Prasana-sys/RF_Controler_UHP/README.md

# RF_Controler_UHP

Controller Firmware - Contains STM32 code files

STM_RF_PCB - Contains PCB files

Documents - Documents used to build this project

old_RFST - old PCB design
