Prasana-sys/RF_Controler_UHP/STM_RF_PCB/3D models/sma-angled-1.snapshot.1/SMA ANGLED.JPG

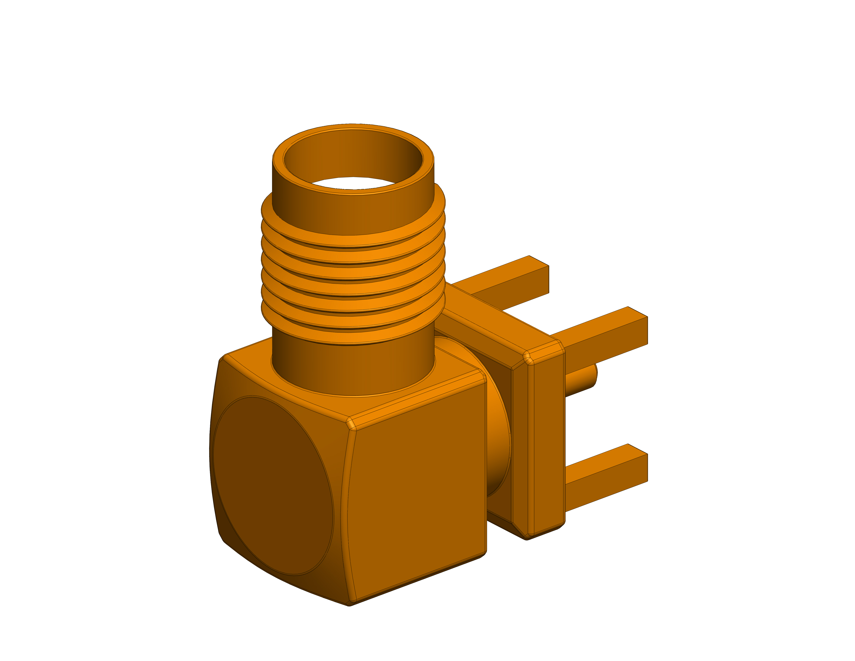
STM_RF_PCB/3D models/sma-angled-1.snapshot.1/SMA ANGLED.JPG
