Prasana-sys/RF_Controler_UHP/Links to buy components.txt

RF Transceiver - https://www.mouser.com/ProductDetail/Nordic-Semiconductor/NRF24L01P?qs=yqaQSyyJnNiKlgjT8AqoOw%3D%3D
