Prasana-sys/RF_Controler_UHP/STM_RF_PCB/3D models/12mm-x-12mm-tactile-switch-push-button-1.snapshot.1/12mm x 12mm Tactile switch.iges

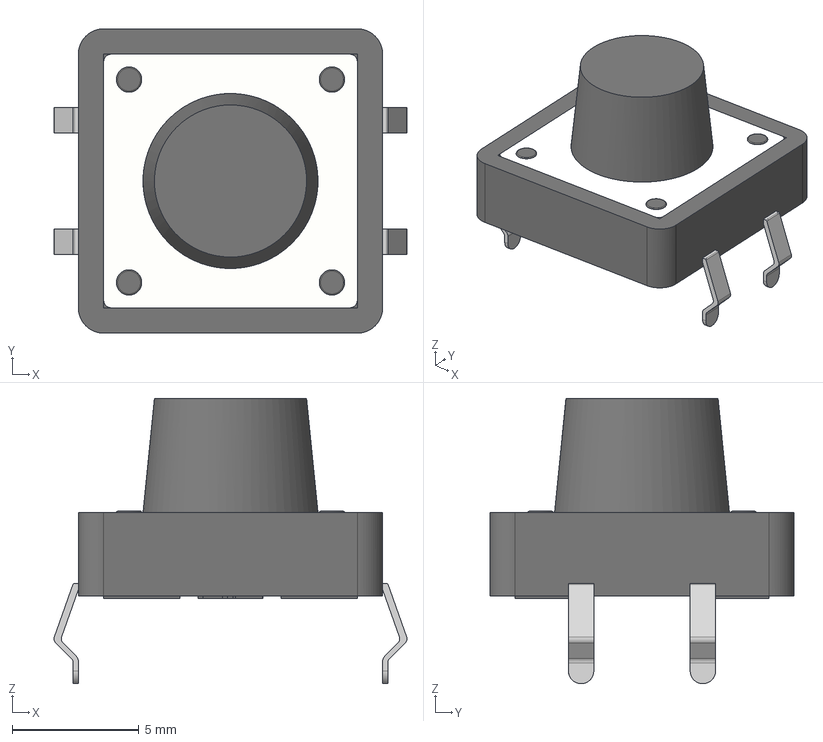
[picture p2: CAD file, 2024-05-29]
STM_RF_PCB/3D models/12mm-x-12mm-tactile-switch-push-button-1.snapshot.1/12mm x 12mm Tactile switch.iges
13.9 x 12.0 x 11.2 mm
