Prasana-sys/RF_Controler_UHP/STM_RF_PCB/3D models/micro-usb-female-type-b-connector-smd-1.snapshot.3/AB2_USB_MICRO_SMD.stl

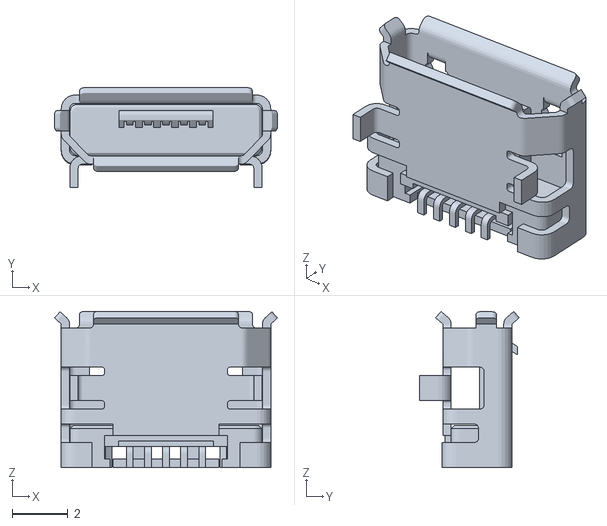
[picture p3: CAD file, 2024-05-21]
STM_RF_PCB/3D models/micro-usb-female-type-b-connector-smd-1.snapshot.3/AB2_USB_MICRO_SMD.stl
8.00 x 3.57 x 5.60
