Prasana-sys/RF_Controler_UHP/STM_RF_PCB/3D models/sma-angled-1.snapshot.1/SMA ANGLED.STEP

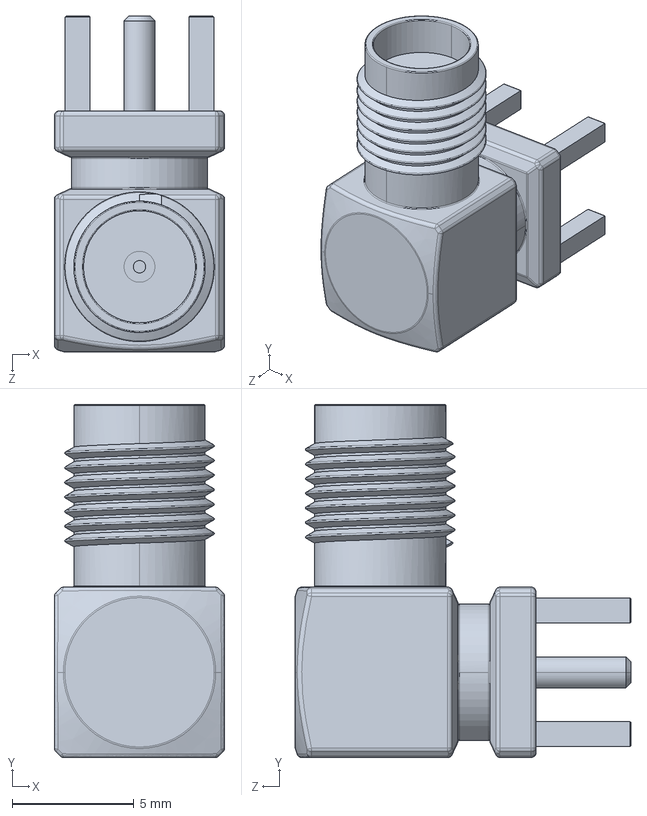
[picture p4: CAD file, 2024-05-24]
STM_RF_PCB/3D models/sma-angled-1.snapshot.1/SMA ANGLED.STEP
7.00 x 14.5 x 13.8 mm
