Prasana-sys/RF_Controler_UHP/STM_RF_PCB/3D models/ul_STM32L432KBU6/UFQFPN-32.step

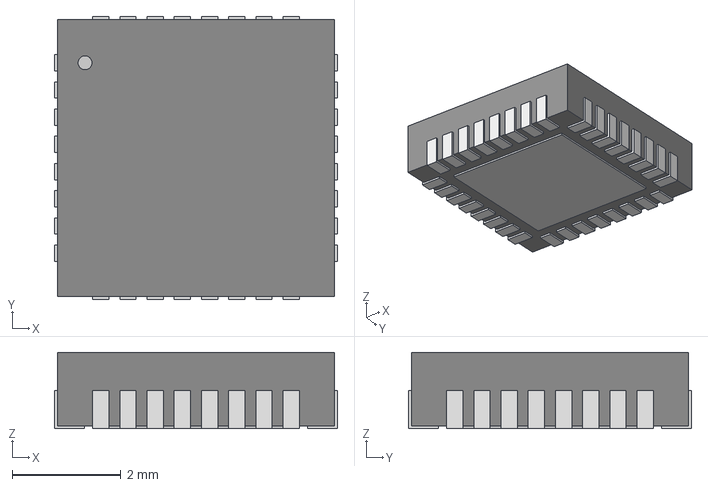
[picture p6: CAD file, 2024-06-02]
STM_RF_PCB/3D models/ul_STM32L432KBU6/UFQFPN-32.step
5.20 x 5.20 x 1.40 mm
