Prasana-sys/RF_Controler_UHP/STM_RF_PCB/3D models/sot23-package-1.snapshot.6/SOT23-6.stp

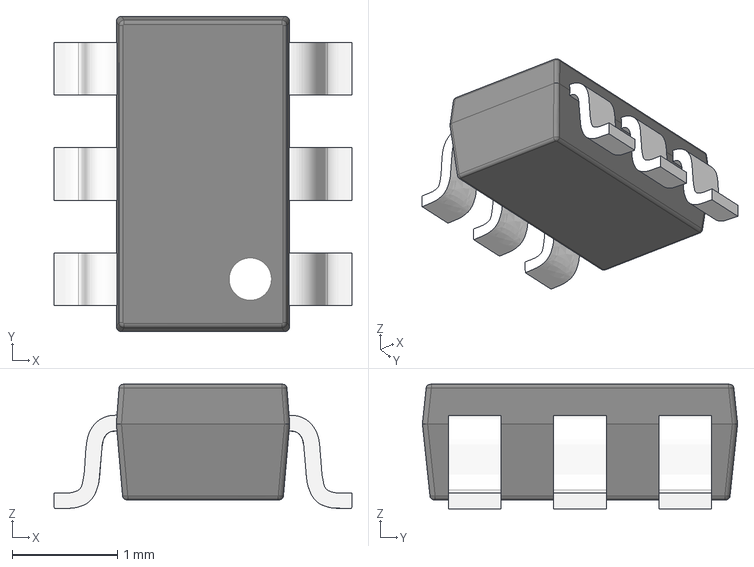
[picture p7: CAD file, 2024-06-02]
STM_RF_PCB/3D models/sot23-package-1.snapshot.6/SOT23-6.stp
2.84 x 3.00 x 1.18 mm
