Prasana-sys/RF_Controler_UHP/(list of files, cad)

Other CAD files:
STM_RF_PCB/3D models/12mm-x-12mm-tactile-switch-push-button-1.snapshot.1/12mm x 12mm Tactile switch Button.step
STM_RF_PCB/3D models/sot23-package-1.snapshot.6/SOT23-4.stp
STM_RF_PCB/3D models/12mm-x-12mm-tactile-switch-push-button-1.snapshot.1/12mm x 12mm Tactile switch.dwg
STM_RF_PCB/3D models/12mm-x-12mm-tactile-switch-push-button-1.snapshot.1/12mm x 12mm Tactile switch.obj
STM_RF_PCB/3D models/sot23-package-1.snapshot.6/SOT23-3.igs
STM_RF_PCB/3D models/sot23-package-1.snapshot.6/SOT23-4.igs
STM_RF_PCB/3D models/sot23-package-1.snapshot.6/SOT23-5.igs
STM_RF_PCB/3D models/sot23-package-1.snapshot.6/SOT23-6.igs
