Prasana-sys/RF_Controler_UHP/STM_RF_PCB/STM_RF_PCB.kicad_pcb

## KiCad design STM_RF_PCB/STM_RF_PCB.kicad_pcb (2024-06-09)

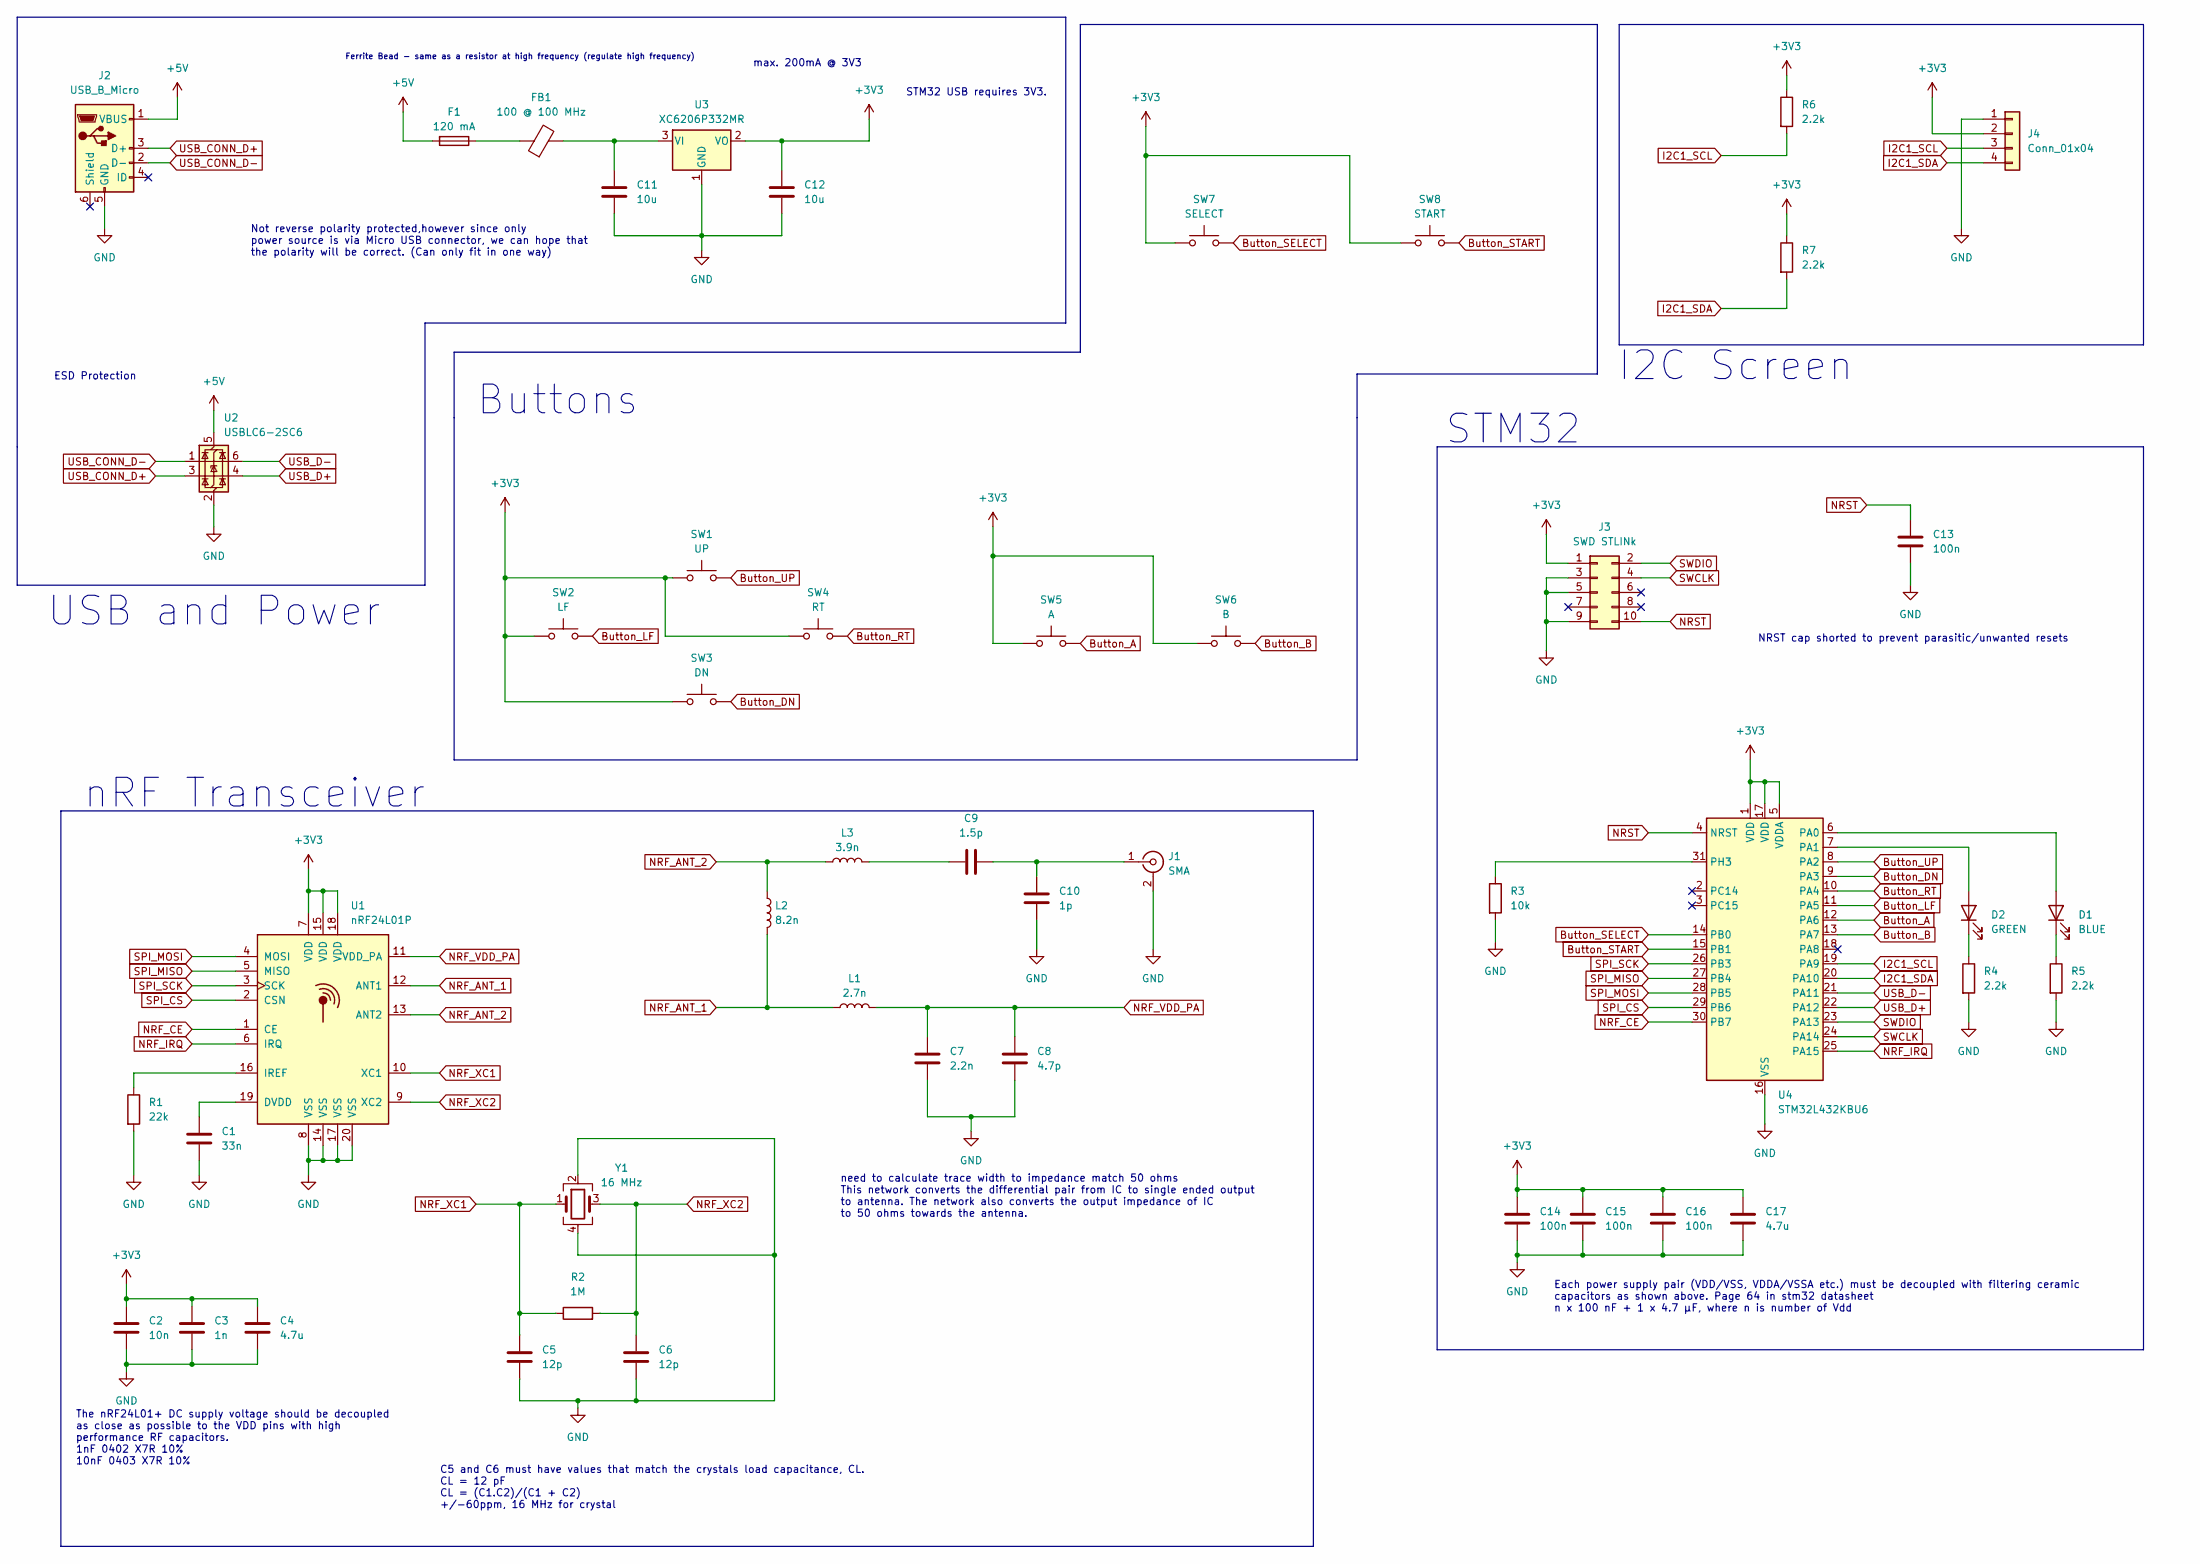
[picture p9: schematic STM_RF_PCB.kicad_sch]

Parts:
C1: 33n; C_0402_1005Metric; Part ID 0402F333M500NT
C2: 10n; R_0603_1608Metric; Part ID 0603B103K101NT
C3: 1n; C_0402_1005Metric; Part ID CC0402KRX7R7BB102
C4, C17: 4.7u; C_0603_1608Metric; Part ID CL10A475KP8NNNC
C5, C6: 12p; C_0402_1005Metric; Part ID 0402CG120J500NT
C7: 2.2n; C_0402_1005Metric; Part ID 0402B222K500NT
C8: 4.7p; C_0402_1005Metric; Part ID 0402CG4R7C500NT
C9: 1.5p; C_0402_1005Metric; Part ID 0402CG1R5C500NT
C10: 1p; C_0402_1005Metric; Part ID 0402CG1R0C500NT
C11, C12: 10u; C_0603_1608Metric; Part ID CL10A106KP8NNNC
C13, C14, C15, C16: 100n; C_0402_1005Metric; Part ID CL05B104KO5NNNC
D1: BLUE; LED_0603_1608Metric; Part ID 19-213/Y2C-CQ2R2L/3T(CY)
D2: GREEN; LED_0603_1608Metric; Part ID 19-217/GHC-YN1P2B18X/6T
F1: 120 mA; Fuse_1206_3216Metric; Part ID nSMD012
FB1: 100 @ 100 MHz; L_0805_2012Metric; Part ID GZ2012D101TF
J1: SMA; SMA-KWE902; Part ID SMA-KWE902
J2: USB_B_Micro; MICRO-02-G2P3-A1T2; Part ID MICRO-02-G2P3-A1T2
J3: SWD STLINk; PinHeader_2x05_P2.54mm_Vertical; Part ID HB-PH8-25425PB2GOP
J4: Conn_01x04; PinSocket_1x04_P2.54mm_Vertical; Part ID C2718488
L1: 2.7n; L_0402_1005Metric; Part ID SDCL1005C2N7STDF
L2: 8.2n; L_0402_1005Metric; Part ID SDCL1005C8N2JTDF
L3: 3.9n; L_0402_1005Metric; Part ID SDCL1005C3N9STDF
R1: 22k; R_0402_1005Metric; Part ID 0402WGF2202TCE
R2: 1M; R_0402_1005Metric; Part ID 0402WGF1004TCE
R3: 10k; R_0402_1005Metric; Part ID 0402WGF1002TCE
R4, R5, R6, R7: 2.2k; R_0603_1608Metric; Part ID 0603WAF2201T5E
SW1: UP; TC-1103-C-D; Part ID TC-1103-C-D
SW2: LF; TC-1103-C-D; Part ID TC-1103-C-D
SW3: DN; TC-1103-C-D; Part ID TC-1103-C-D
SW4: RT; TC-1103-C-D; Part ID TC-1103-C-D
SW5: A; TC-1103-C-D; Part ID TC-1103-C-D
SW6: B; TC-1103-C-D; Part ID TC-1103-C-D
SW7: SELECT; TC-1103-C-D; Part ID TC-1103-C-D
SW8: START; TC-1103-C-D; Part ID TC-1103-C-D
U1: nRF24L01P; QFN-20-1EP_4x4mm_P0.5mm_EP2.5x2.5mm
U2: USBLC6-2SC6; SOT-23-6
U3: XC6206P332MR
U4: STM32L432KBU6; Part ID C94784
Y1: 16 MHz; Crystal_SMD_3225-4Pin_3.2x2.5mm; Part ID X322516MLB4SI

Connections:
+3V3: C2.1, C3.1, C4.1, C12.1, C14.1, C15.1, C16.1, C17.1, J3.1, J4.2, R6.1, R7.1, SW1.1, SW2.1, SW3.1, SW4.1, SW5.1, SW6.1, SW7.1, SW8.1, U1.7 (VDD), U1.15 (VDD), U1.18 (VDD), U3.2 (VO), U4.1 (VDD), U4.5 (VDDA), U4.17 (VDD); also elsewhere on the board
+5V: F1.2, J2.1 (VBUS), U2.5 (VBUS)
Button_A: SW5.2, U4.12 (PA6)
Button_B: SW6.2, U4.13 (PA7)
Button_DN: SW3.2, U4.9 (PA3)
Button_LF: SW2.2, U4.11 (PA5)
Button_RT: SW4.2, U4.10 (PA4)
Button_SELECT: SW7.2, U4.14 (PB0)
Button_START: SW8.2, U4.15 (PB1)
Button_UP: SW1.2, U4.8 (PA2)
GND: C1.2, C2.2, C3.2, C4.2, C5.2, C6.2, C7.2, C8.2, C10.2, C11.2, C12.2, C13.2, C14.2, C15.2, C16.2, C17.2, J1.2 (Ext), J2.5 (GND), J3.3, J3.5, J3.9, J4.1, R1.2, R3.2, R4.2, R5.2, U1.8 (VSS), U1.14 (VSS), U1.17 (VSS), U1.20 (VSS), U2.2 (GND), U3.1 (GND), U4.16 (VSS), U4.32 (VSS), U4.33 (VSS), Y1.2, Y1.4; also elsewhere on the board
I2C1_SCL: J4.3, R6.2, U4.19 (PA9)
I2C1_SDA: J4.4, R7.2, U4.20 (PA10)
NRF_ANT_1: L1.1, L2.2, U1.12 (ANT1)
NRF_ANT_2: L2.1, L3.1, U1.13 (ANT2)
NRF_CE: U1.1 (CE), U4.30 (PB7)
NRF_IRQ: U1.6 (IRQ), U4.25 (PA15)
NRF_VDD_PA: C7.1, C8.1, L1.2, U1.11 (VDD_PA)
NRF_XC1: C5.1, R2.1, U1.10 (XC1), Y1.1
NRF_XC2: C6.1, R2.2, U1.9 (XC2), Y1.3
NRST: C13.1, J3.10, U4.4 (NRST)
unnamed: C9.1, L3.2
unnamed: D1.2 (A), U4.6 (PA0)
unnamed: D1.1 (K), R5.1
unnamed: D2.2 (A), U4.7 (PA1)
unnamed: D2.1 (K), R4.1
unnamed: F1.1, FB1.1
unnamed: C9.2, C10.1, J1.1 (In)
unnamed: C1.1, U1.19 (DVDD)
unnamed: R1.1, U1.16 (IREF)
unnamed: C11.1, FB1.2, U3.3 (VI)
unnamed: R3.1, U4.31 (PH3)
SPI_CS: U1.2 (CSN), U4.29 (PB6)
SPI_MISO: U1.5 (MISO), U4.27 (PB4)
SPI_MOSI: U1.4 (MOSI), U4.28 (PB5)
SPI_SCK: U1.3 (SCK), U4.26 (PB3)
SWCLK: J3.4, U4.24 (PA14)
SWDIO: J3.2, U4.23 (PA13)
USB_CONN_D+: J2.3 (D+), U2.3 (I/O2)
USB_CONN_D-: J2.2 (D-), U2.1 (I/O1)
USB_D+: U2.4 (I/O2), U4.22 (PA12)
USB_D-: U2.6 (I/O1), U4.21 (PA11)

Notes on the sheet:
I2C Screen
Buttons
NRST cap shorted to prevent parasitic/unwanted resets
need to calculate trace width to impedance match 50 ohms This network converts the differential pair from IC to single ended output to antenna. The network also converts the output impedance of IC to 50 ohms towards the antenna.
The nRF24L01+ DC supply voltage should be decoupled as close as possible to the VDD pins with high performance RF capacitors. 1nF 0402 X7R 10% 10nF 0403 X7R 10%
nRF Transceiver
STM32
Each power supply pair (VDD/VSS, VDDA/VSSA etc.) must be decoupled with filtering ceramic capacitors as shown above. Page 64 in stm32 datasheet n x 100 nF + 1 x 4.7 μF, where n is number of Vdd
ESD Protection
Not reverse polarity protected,however since only power source is via Micro USB connector, we can hope that the polarity will be correct. (Can only fit in one way)
C5 and C6 must have values that match the crystals load capacitance, CL. CL = 12 pF CL = (C1.C2)/(C1 + C2) +/-60ppm, 16 MHz for crystal
max. 200mA @ 3V3
STM32 USB requires 3V3.
USB and Power
Ferrite Bead - same as a resistor at high frequency (regulate high frequency)

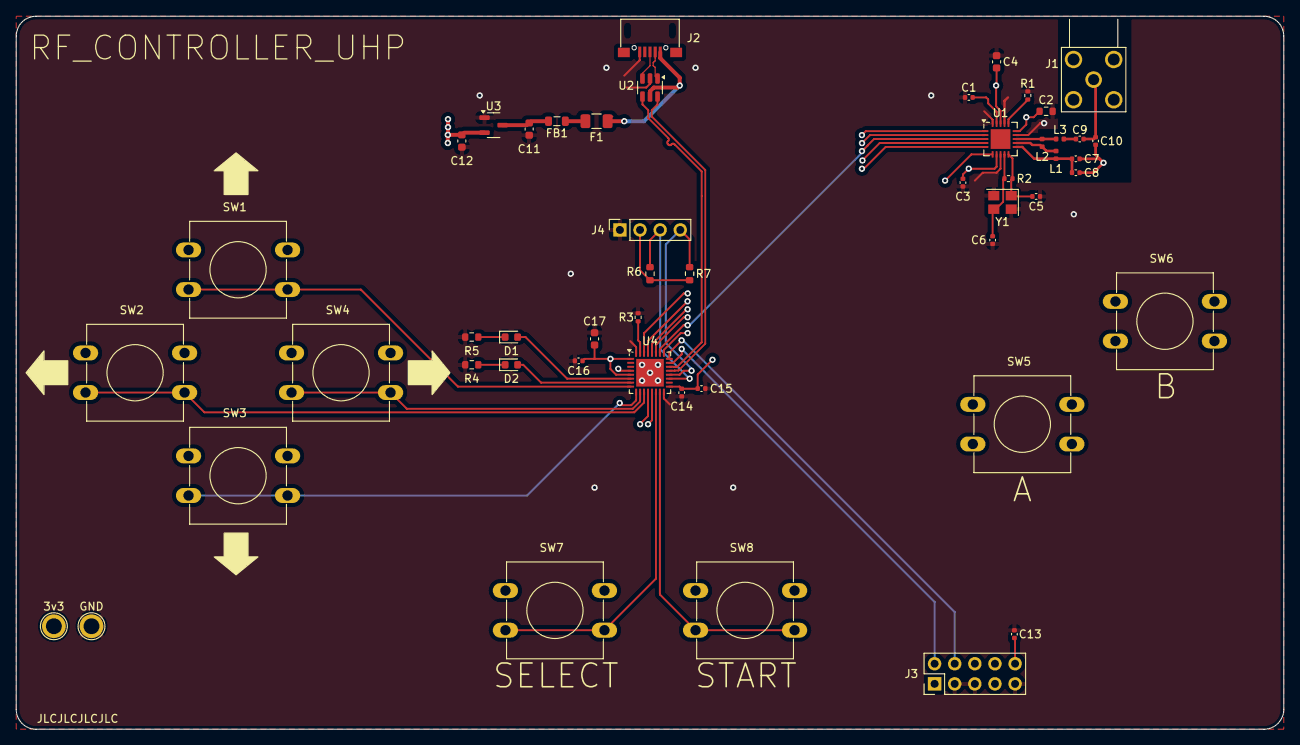
[picture p10: board STM_RF_PCB.kicad_pcb from above]

Board: 4 copper layers, 160.0 x 90.0 mm, 50 parts (0 on the bottom side), 42 nets.

Other parts of the board:
3v3: TestPoint_Plated_Hole_D2.0mm
GND: TestPoint_Plated_Hole_D2.0mm

Their connections:
+3V3: 3v3.1; also elsewhere on the board
GND: GND.1; also elsewhere on the board
