Prasana-sys/RF_Controler_UHP/old_RFST/RFST.kicad_pcb

## KiCad design old_RFST/RFST.kicad_pcb (2024-05-20, an earlier design)

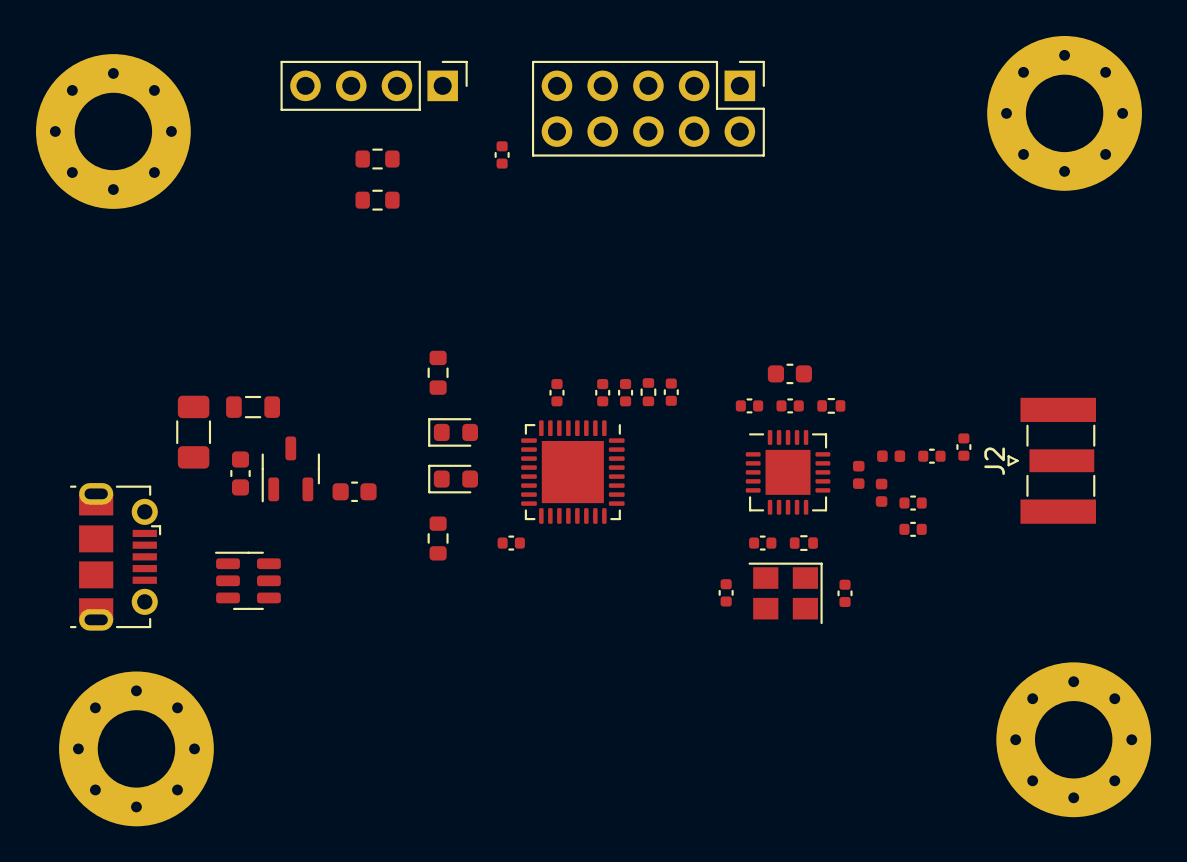
[picture p11: board RFST.kicad_pcb from above]

Board: 2 copper layers, 45 parts (0 on the bottom side), 34 nets, no tracks yet.

Parts:
C1, C2, C8: 10u; C_0603_1608Metric
C3, C5, C6, C7: 100n; C_0402_1005Metric
C4: 1u; C_0402_1005Metric
C9, C10, C11: 10n; C_0402_1005Metric
C12: 33n; C_0402_1005Metric
C13, C14: 12p; C_0402_1005Metric
C15: 1p5; C_0402_1005Metric
C16: 1p; C_0402_1005Metric
C17: 2n2; C_0402_1005Metric
C18: 4p7; C_0402_1005Metric
D1: GREEN; LED_0603_1608Metric
D2: BLUE; LED_0603_1608Metric
F1: 100mA; Fuse_1206_3216Metric
FB1: 100 @ 100MHz; L_0805_2012Metric
H1, H2, H3, H4: MountingHole_Pad; MountingHole_4.3mm_M4_Pad_Via
J1: USB_B_Micro; USB_Micro-B_Molex-105017-0001
J2: SMA; SMA_Samtec_SMA-J-P-X-ST-EM1_EdgeMount
J3: 10 pin for stlink; PinHeader_2x05_P2.54mm_Vertical
J4: Conn_01x04; PinHeader_1x04_P2.54mm_Vertical
L1: 3n9; L_0402_1005Metric
L2: 8n2; L_0402_1005Metric
L3: 2n7; L_0402_1005Metric
R1: 10k; R_0402_1005Metric
R2, R3, R6, R7: 2k2; R_0603_1608Metric
R4: 22k; R_0402_1005Metric
R5: 1M; R_0402_1005Metric
U1: XC6206P332MR; SOT-23-3
U2: USBLC6-2SC6; SOT-23-6
U3: STM32L432KBUx; QFN-32-1EP_5x5mm_P0.5mm_EP3.45x3.45mm
U4: nRF24L01P; QFN-20-1EP_4x4mm_P0.5mm_EP2.5x2.5mm
Y1: 16MHz; Crystal_SMD_3225-4Pin_3.2x2.5mm

Connections:
+3V3: C2.1, C4.1, C5.1, C6.1, C7.1, C8.1, C9.1, C10.1, C11.1, J3.1, J4.3, R6.1, R7.1, U1.2 (VO), U3.1 (VDD), U3.5 (VDDA), U3.17 (VDD), U4.7 (VDD), U4.15 (VDD), U4.18 (VDD)
+5V: F1.1, J1.1 (VBUS), U2.5 (VBUS)
GND: C1.2, C2.2, C3.2, C4.2, C5.2, C6.2, C7.2, C8.2, C9.2, C10.2, C11.2, C12.2, C13.2, C14.2, C16.1, C17.1, C18.1, H1.1, H2.1, H3.1, H4.1, J1.5 (GND), J2.2 (Ext), J3.3, J3.5, J3.9, J4.4, R1.2, R2.2, R3.2, R4.2, U1.1 (GND), U2.2 (GND), U3.16 (VSS), U3.32 (VSS), U3.33 (VSS), U4.8 (VSS), U4.14 (VSS), U4.17 (VSS), U4.20 (VSS), Y1.2, Y1.4
I2C1_SCL: J4.2, R6.2, U3.19 (PA9)
I2C1_SDA: J4.1, R7.2, U3.20 (PA10)
NRF_ANT1: L2.2, L3.2, U4.12 (ANT1)
NRF_ANT2: L1.1, L2.1, U4.13 (ANT2)
NRF_CE: U3.30 (PB7), U4.1 (CE)
NRF_IRQ: U3.25 (PA15), U4.6 (IRQ)
NRF_VDD_PA: C17.2, C18.2, L3.1, U4.11 (VDD_PA)
NRF_XC1: C13.1, R5.2, U4.10 (XC1), Y1.1
NRF_XC2: C14.1, R5.1, U4.9 (XC2), Y1.3
NRST: C3.1, J3.10, U3.4 (NRST)
unnamed: C15.2, L1.2
unnamed: D1.2 (A), U3.9 (PA3)
unnamed: D1.1 (K), R2.1
unnamed: D2.2 (A), U3.8 (PA2)
unnamed: D2.1 (K), R3.1
unnamed: F1.2, FB1.1
unnamed: C15.1, C16.2, J2.1 (In)
unnamed: C1.1, FB1.2, U1.3 (VI)
unnamed: R1.1, U3.31 (PH3)
unnamed: C12.1, U4.19 (DVDD)
unnamed: R4.1, U4.16 (IREF)
SPI3_CS: U3.29 (PB6), U4.2 (CSN)
SPI3_MISO: U3.27 (PB4), U4.5 (MISO)
SPI3_MOSI: U3.28 (PB5), U4.4 (MOSI)
SPI3_SCK: U3.26 (PB3), U4.3 (SCK)
SWCLK: J3.4, U3.24 (PA14)
SWDIO: J3.2, U3.23 (PA13)
USB_CONN_D+: J1.3 (D+), U2.6 (IO1)
USB_CONN_D-: J1.2 (D-), U2.4 (IO2)
USB_D+: U2.1 (IO1), U3.22 (PA12)
USB_D-: U2.3 (IO2), U3.21 (PA11)
