Prasana-sys/RF_Controler_UHP/Controller_firmware/Core/Src/main.c

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
/* Includes ------------------------------------------------------------------*/
#include "main.h"

/* USER CODE BEGIN Includes */
#include "NRF24L01.h"
#include "ssd1306.h"
#include "fonts.h"
#include "test.h"
/* USER CODE END Includes */

I2C_HandleTypeDef hi2c1;

SPI_HandleTypeDef hspi1;

PCD_HandleTypeDef hpcd_USB_FS;

void SystemClock_Config(void);
static void MX_GPIO_Init(void);
static void MX_I2C1_Init(void);
static void MX_SPI1_Init(void);
static void MX_USB_PCD_Init(void);
/* USER CODE BEGIN PFP */
void EXTI2_IRQHandler(void);
void EXTI3_IRQHandler(void);
void EXTI4_IRQHandler(void);
void EXTI5_IRQHandler(void);
void EXTI6_IRQHandler(void);
void EXTI7_IRQHandler(void);
void EXTI9_5_IRQHandler(void); // Button 6,7 for GPIO_PIN_6 and GPIO_PIN_7
void EXTI15_10_IRQHandler(void); // Button 8 for GPIO_PIN_10
/* USER CODE END PFP */

/* USER CODE BEGIN 0 */

// uint8_t RxAddress[] = {0x00,0xDD,0xCC,0xBB,0xAA};
// uint8_t RxData[32];


uint8_t data;

uint8_t TxAddress[] = {0xEE,0xDD,0xCC,0xBB,0xAA};
// uint8_t TxData[] = "Hello World\n";

void display(uint8_t num)
{
	char buf[11];
	sprintf(buf, "%d       ", num);

	SSD1306_GotoXY (10,10);
	SSD1306_Puts (buf, &Font_11x18, 1);
	SSD1306_UpdateScreen();
}

/* USER CODE END 0 */

/**
  * @brief  The application entry point.
  * @retval int
  */
int main(void)
{

  /* MCU Configuration--------------------------------------------------------*/

  /* Reset of all peripherals, Initializes the Flash interface and the Systick. */
  HAL_Init();

  /* Configure the system clock */
  SystemClock_Config();

  /* Initialize all configured peripherals */
  MX_GPIO_Init();
  MX_I2C1_Init();
  MX_SPI1_Init();
  MX_USB_PCD_Init();
  /* USER CODE BEGIN 2 */

  NRF24_Init();

  // NRF24_RxMode(RxAddress, 10);

  NRF24_TxMode(TxAddress, 10);

  // NRF24_ReadAll(data);

  SSD1306_Init();

  SSD1306_GotoXY (10,30);
  SSD1306_Puts ("   SUDAR", &Font_11x18, 1);
  SSD1306_UpdateScreen();
  SSD1306_GotoXY (10,10);
  SSD1306_Puts ("  TITANA", &Font_11x18, 1);
  SSD1306_UpdateScreen();

  HAL_Delay(1500);

  uint8_t i = 0;

  /* USER CODE END 2 */

  /* Infinite loop */
  /* USER CODE BEGIN WHILE */
  while (1)
  {
    /* USER CODE END WHILE */

    /* USER CODE BEGIN 3 */
  }
  /* USER CODE END 3 */
}

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
/* USER CODE BEGIN 4 */
uint8_t numberToSend = 0;

/* Button Interrupt Handlers */
void EXTI2_IRQHandler(void) {
    if (__HAL_GPIO_EXTI_GET_IT(GPIO_PIN_2) != RESET) {
        data = 1; // Data for Button 1
        NRF24_Transmit(&data);
        __HAL_GPIO_EXTI_CLEAR_IT(GPIO_PIN_2); // Clear interrupt
    }
    HAL_GPIO_WritePin(GPIOA, GPIO_PIN_1, GPIO_PIN_SET);
    HAL_Delay(500);
    HAL_GPIO_WritePin(GPIOA, GPIO_PIN_1, GPIO_PIN_RESET);
}

void EXTI3_IRQHandler(void) {
    if (__HAL_GPIO_EXTI_GET_IT(GPIO_PIN_3) != RESET) {
        data = 2; // Data for Button 2
        NRF24_Transmit(&data);
        __HAL_GPIO_EXTI_CLEAR_IT(GPIO_PIN_3);
    }
    HAL_GPIO_WritePin(GPIOA, GPIO_PIN_1, GPIO_PIN_SET);
    HAL_Delay(500);
    HAL_GPIO_WritePin(GPIOA, GPIO_PIN_1, GPIO_PIN_RESET);
}

void EXTI4_IRQHandler(void) {
    if (__HAL_GPIO_EXTI_GET_IT(GPIO_PIN_4) != RESET) {
        data = 3; // Data for Button 3
        NRF24_Transmit(&data);
        __HAL_GPIO_EXTI_CLEAR_IT(GPIO_PIN_4);
    }
    HAL_GPIO_WritePin(GPIOA, GPIO_PIN_1, GPIO_PIN_SET);
    HAL_Delay(500);
    HAL_GPIO_WritePin(GPIOA, GPIO_PIN_1, GPIO_PIN_RESET);
}

void EXTI9_5_IRQHandler(void) {
    if (__HAL_GPIO_EXTI_GET_IT(GPIO_PIN_5)) { data = 4; NRF24_Transmit(&data); __HAL_GPIO_EXTI_CLEAR_IT(GPIO_PIN_5); }
    if (__HAL_GPIO_EXTI_GET_IT(GPIO_PIN_6)) { data = 5; NRF24_Transmit(&data); __HAL_GPIO_EXTI_CLEAR_IT(GPIO_PIN_6); }
    if (__HAL_GPIO_EXTI_GET_IT(GPIO_PIN_7)) { data = 6; NRF24_Transmit(&data); __HAL_GPIO_EXTI_CLEAR_IT(GPIO_PIN_7); }
    if (__HAL_GPIO_EXTI_GET_IT(GPIO_PIN_8)) { data = 7; NRF24_Transmit(&data); __HAL_GPIO_EXTI_CLEAR_IT(GPIO_PIN_8); }
    HAL_GPIO_WritePin(GPIOA, GPIO_PIN_1, GPIO_PIN_SET);
    HAL_Delay(500);
    HAL_GPIO_WritePin(GPIOA, GPIO_PIN_1, GPIO_PIN_RESET);
}

void EXTI15_10_IRQHandler(void) {
    if (__HAL_GPIO_EXTI_GET_IT(GPIO_PIN_10) != RESET) {
        data = 8; // Data for Button 8
        NRF24_Transmit(&data);
        __HAL_GPIO_EXTI_CLEAR_IT(GPIO_PIN_10);
    }
    HAL_GPIO_WritePin(GPIOA, GPIO_PIN_1, GPIO_PIN_SET);
    HAL_Delay(500);
    HAL_GPIO_WritePin(GPIOA, GPIO_PIN_1, GPIO_PIN_RESET);
}


/* USER CODE END 4 */
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
