Prasana-sys/RF_Controler_UHP/Controller_firmware/Controller_firmware.ioc

Mcu.UserName=STM32L432KBUx
PA0.GPIO_Label=blue
PA0.Signal=GPIO_Output
PA1.GPIO_Label=green
PA1.Signal=GPIO_Output
PA10.Signal=I2C1_SDA
PA11.Signal=USB_DM
PA12.Signal=USB_DP
PA2.Signal=GPXTI2
PA3.Signal=GPXTI3
PA4.Signal=GPXTI4
PA5.Signal=GPXTI5
PA6.Signal=GPXTI6
PA7.Signal=GPXTI7
PA9.Signal=I2C1_SCL
PB0.Signal=GPXTI0
PB1.Signal=GPXTI1
PB5.Signal=SPI1_MOSI
PB6.Signal=GPIO_Output
