Prasana-sys/RF_Controler_UHP/Controller_firmware/Core/Inc/main.h

#define blue_Pin GPIO_PIN_0
#define blue_GPIO_Port GPIOA
#define green_Pin GPIO_PIN_1
#define green_GPIO_Port GPIOA
