Prasana-sys/RF_Controler_UHP/(commit log)

2024-02-06 Initial commit for HW development
    [RFST.kicad_pcb, RFST.kicad_sch]
2024-05-20 Added new project with buttons in schematic
    [RFST.kicad_pcb, RFST.kicad_sch, STM_RF_PCB.kicad_pcb, STM_RF_PCB.kicad_sch]
2024-05-20 Added I2C interface back and changed to SMA antenna
    [STM_RF_PCB.kicad_pcb, STM_RF_PCB.kicad_sch]
2024-05-20 Adding footprint for micro usb
    [STM_RF_PCB.kicad_sch]
2024-05-21 Schematic Symbols update for KiCad 8.0, updated footprint for Micro USB, added 3d model to footprint
    [AB2_USB_MICRO_SMD.stl, STM_RF_PCB.kicad_sch]
2024-05-22 Added part IDs, footprints for all in Power Management
    [STM_RF_PCB.kicad_sch]
2024-05-22 Added footprints and Part ID for I2C Screen
    [STM_RF_PCB.kicad_sch]
2024-05-23 Small fixes
    [STM_RF_PCB.kicad_sch]
2024-05-23 Footprints, part ID for RF block except SMA
    [STM_RF_PCB.kicad_sch]
2024-05-24 Footprint and Part ID for SMA antenna
    [SMA ANGLED.STEP, STM_RF_PCB.kicad_sch]
2024-05-28 STM32 block footprints, Part IDs
    [STM_RF_PCB.kicad_sch]
2024-05-29 Buttons block, footprint and part ID
    [12mm x 12mm Tactile switch Button.step, 12mm x 12mm Tactile switch.dwg, 12mm x 12mm Tactile switch.iges, 12mm x 12mm Tactile switch.obj, STM_RF_PCB.kicad_sch]
2024-05-29 Work on PCB
    [STM_RF_PCB.kicad_pcb]
2024-05-31 Added start select buttons
    [STM_RF_PCB.kicad_pcb, STM_RF_PCB.kicad_sch]
2024-05-31 PCB work
    [STM_RF_PCB.kicad_pcb, STM_RF_PCB.kicad_sch]
2024-06-07 PCB work complete + fab outputs
    [STM_RF_PCB-B_Cu.gbr, STM_RF_PCB-B_Mask.gbr, STM_RF_PCB-B_Paste.gbr, STM_RF_PCB-B_Silkscreen.gbr, STM_RF_PCB-Edge_Cuts.gbr, STM_RF_PCB-F_Cu.gbr, STM_RF_PCB-F_Mask.gbr, STM_RF_PCB-F_Paste.gbr]
2024-06-07 Removed fab outputs plus fixed trace impednances
    [STM_RF_PCB-B_Cu.gbr, STM_RF_PCB-B_Mask.gbr, STM_RF_PCB-B_Paste.gbr, STM_RF_PCB-B_Silkscreen.gbr, STM_RF_PCB-Edge_Cuts.gbr, STM_RF_PCB-F_Cu.gbr, STM_RF_PCB-F_Mask.gbr, STM_RF_PCB-F_Paste.gbr]
2024-06-08 added san jose 2024
    [STM_RF_PCB.kicad_pcb]
2024-06-09 Fab outputs
    [STM_RF_PCB-B_Cu.gbr, STM_RF_PCB-B_Mask.gbr, STM_RF_PCB-B_Paste.gbr, STM_RF_PCB-B_Silkscreen.gbr, STM_RF_PCB-Edge_Cuts.gbr, STM_RF_PCB-F_Cu.gbr, STM_RF_PCB-F_Mask.gbr, STM_RF_PCB-F_Paste.gbr]
